urish/serial-7segment-20mm/pcb/simon-7segment.brd

## EAGLE design pcb/simon-7segment.brd (2016-06-17)

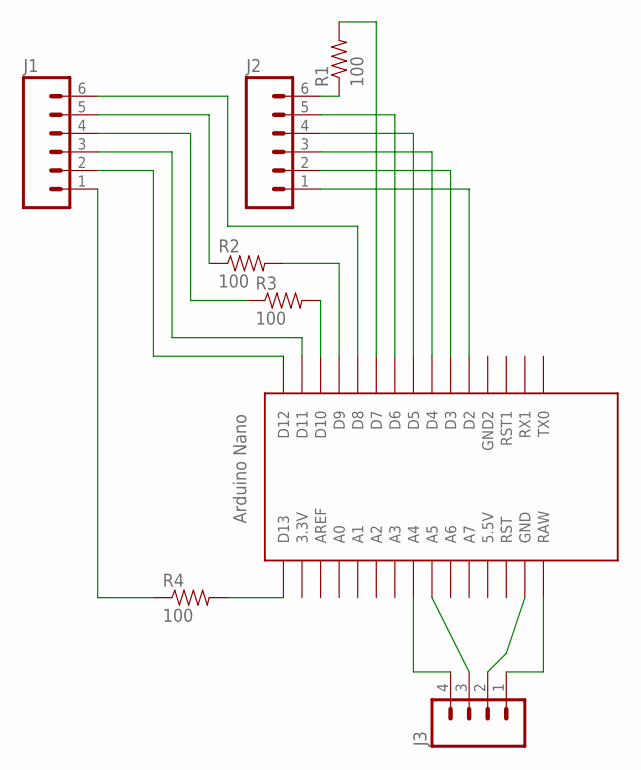
[picture p3: schematic simon-7segment.sch]

Parts:
J1, J2: M06SILK_FEMALE_PTH; 1X06
J3: M04LOCK_LONGPADS; 1X04_LOCK_LONGPADS
R1, R2, R3, R4: 100; AXIAL-0.4
U$1: NANO

Connections:
5V: J3.1, U$1.RAW
12: J1.1, R4.P$1 (1)
GND: J3.2, U$1.GND
unnamed: J2.1, U$1.D2
unnamed: J2.2, U$1.D3
unnamed: J2.3, U$1.D4
unnamed: J2.4, U$1.D5
unnamed: J2.5, U$1.D6
unnamed: J2.6, R1.P$1 (1)
unnamed: R1.P$2 (2), U$1.D7
unnamed: J1.6, U$1.D8
unnamed: J1.5, R2.P$1 (1)
unnamed: R2.P$2 (2), U$1.D9
unnamed: J1.4, R3.P$1 (1)
unnamed: R3.P$2 (2), U$1.D10
unnamed: J1.3, U$1.D11
unnamed: J1.2, U$1.D12
unnamed: R4.P$2 (2), U$1.D13
SCL: J3.3, U$1.A5
SDA: J3.4, U$1.A4

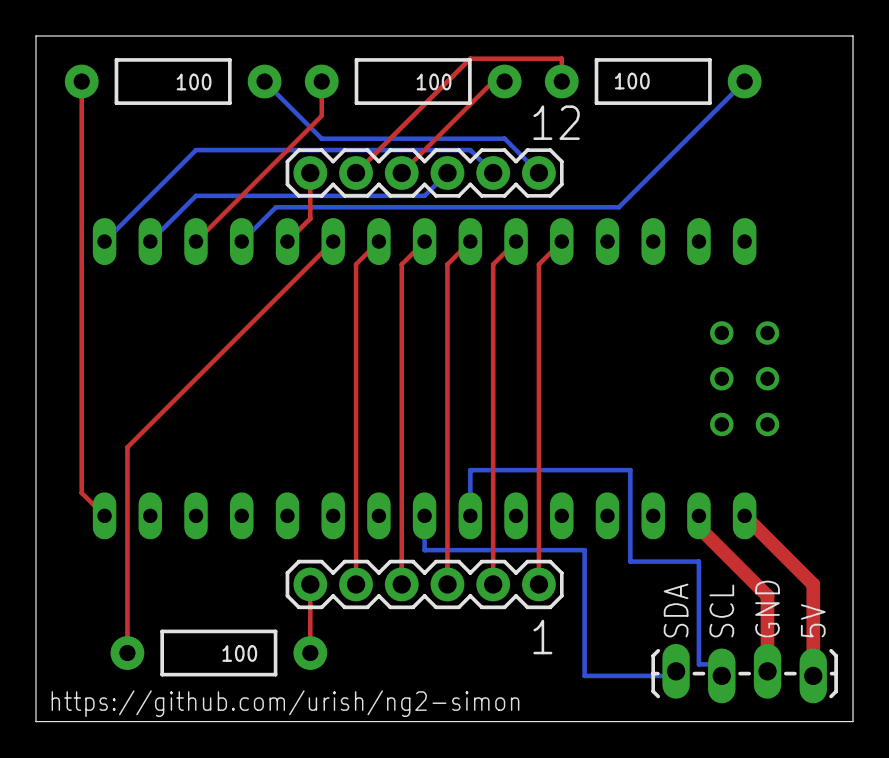
[picture p4: board simon-7segment.brd from above]

Board: 2 copper layers, 45.4 x 38.1 mm, 8 parts (0 on the bottom side), 20 nets.
